thomask77/drquad32/Docs/DrQuad32 Mainboard (Rev B draft) BOM.ods

Layer | Comment | Footprint | Quantity | Designator
Top | 100n | CAPC0402N | 5 | C8, C10, C11, C14, C17
Top | 100R | RESC0402N | 2 | R11, R12
Top | 10k | RESC0402N | 3 | R5, R8, R153
Top | 10uF/25V | CAPC1206N | 12 | C1, C2, C3, C4, C7, C12, C13, C19, C21, C24, C25, C26
Top | 1k | RESC0402N | 5 | R1, R3, R4, R10, R15
Top | 22n | CAPC0603N | 1 | C15
Top | 22u/10V | CAPC1206N | 3 | C5, C6, C23
Top | 2n2/50V | CAPC0402N | 1 | C9
Top | 3k9 | RESC0402N | 1 | R6
Top | 4u7/3A | LDSMSDR0603A | 1 | L1
Top | 820R | RESC0402N | 1 | R7
Top | AT45DB321 | SOIC-8 DATAFLASH | 1 | DF1
Top | BC817-25 | SOT-23A | 5 | Q1, Q2, Q3, Q4, Q5
Top | BMP180 | Bosch BMP180 | 1 | IC2
Top | GREEN | LED0603_GREEN | 1 | LINK
Top | HEADER 1x3 | HEADER 1x3 2.54MM | 2 | PPM, SWD
Top | HEADER 1x4 | HEADER 1x4 2.54MM | 2 | GPS, I2C
Top | HEADER 1x8 | HEADER 1x8 2.54MM | 1 | P2
Top | HEADER 2x8 | HEADER 2x8 2.54MM | 1 | P1
Top | LM1117MP-3.3 | MP04A_N | 1 | U1
Top | MCP16323 | QFN50P300X300X90-16N | 1 | U2
Top | MPU-9150 | Invensense_QFN24 | 1 | IC3
Top | RED | LED0603_RED | 1 | RSSI
Top | USB | USB_MICRO_FCI | 1 | USB
Top | XBee (Pro) | XBeePro_Socket_SMD | 1 | XBee
Bottom | 0R | RESC0402N | 1 | R39
Bottom | 100n | CAPC0402N | 7 | C16, C22, C43, C47, C50, C57, C61
Bottom | 100n | CAPC0603N | 12 | C32, C34, C36, C38, C41, C52, C53, C59, C64, C67, C70, C72
Bottom | 10k | RESC0402N | 12 | R9, R22, R25, R26, R27, R28, R29, R30, R31, R32, R33, R38
Bottom | 10n | CAPC0402N | 12 | C28, C29, C30, C39, C42, C51, C55, C56, C62, C68, C71, C74
Bottom | 16MHz | XO2.5x2.0 | 1 | X1
Bottom | 1k | RESC0402N | 15 | R17, R19, R21, R23, R34, R35, R37, R41, R42, R45, R46, R48, R51, R53, R55
Bottom | 1uF/25V | CAPC0603N | 12 | C31, C33, C35, C37, C40, C49, C54, C58, C65, C66, C69, C73
Bottom | 22p | CAPC0402N | 2 | C45, C46
Bottom | 2u2 | CAPC0402N | 3 | C18, C20, C60
Bottom | 330uF/25V | CAPE_RM5_D10_H12 | 4 | C27, C48, C63, C75
Bottom | 5k6 | RESC0402N | 13 | R16, R18, R20, R24, R36, R40, R43, R44, R47, R49, R50, R52, R54
Bottom | 600R/100MHz | RESC0402N | 1 | LF1
Bottom | 74HC1G14 | SOT65P210X100-5N | 1 | IC1
Bottom | MBR120 | D_SM_SOD123_H135A | 1 | D1
Bottom | SiC780 | DRMOS40 | 12 | DR1, DR2, DR3, DR4, DR5, DR6, DR7, DR8, DR9, DR10, DR11, DR12
Bottom | STM32F4 | TSQFP50P1600X1600X160-100N | 1 | IC4
