thomask77/drquad32/Docs/TODO.TXT

* memmang 4
* ccm-ram direkt eintragen (NOLOAD)
