thomask77/drquad32/Docs/DrQuad32 Mainboard (Rev B draft).pdf

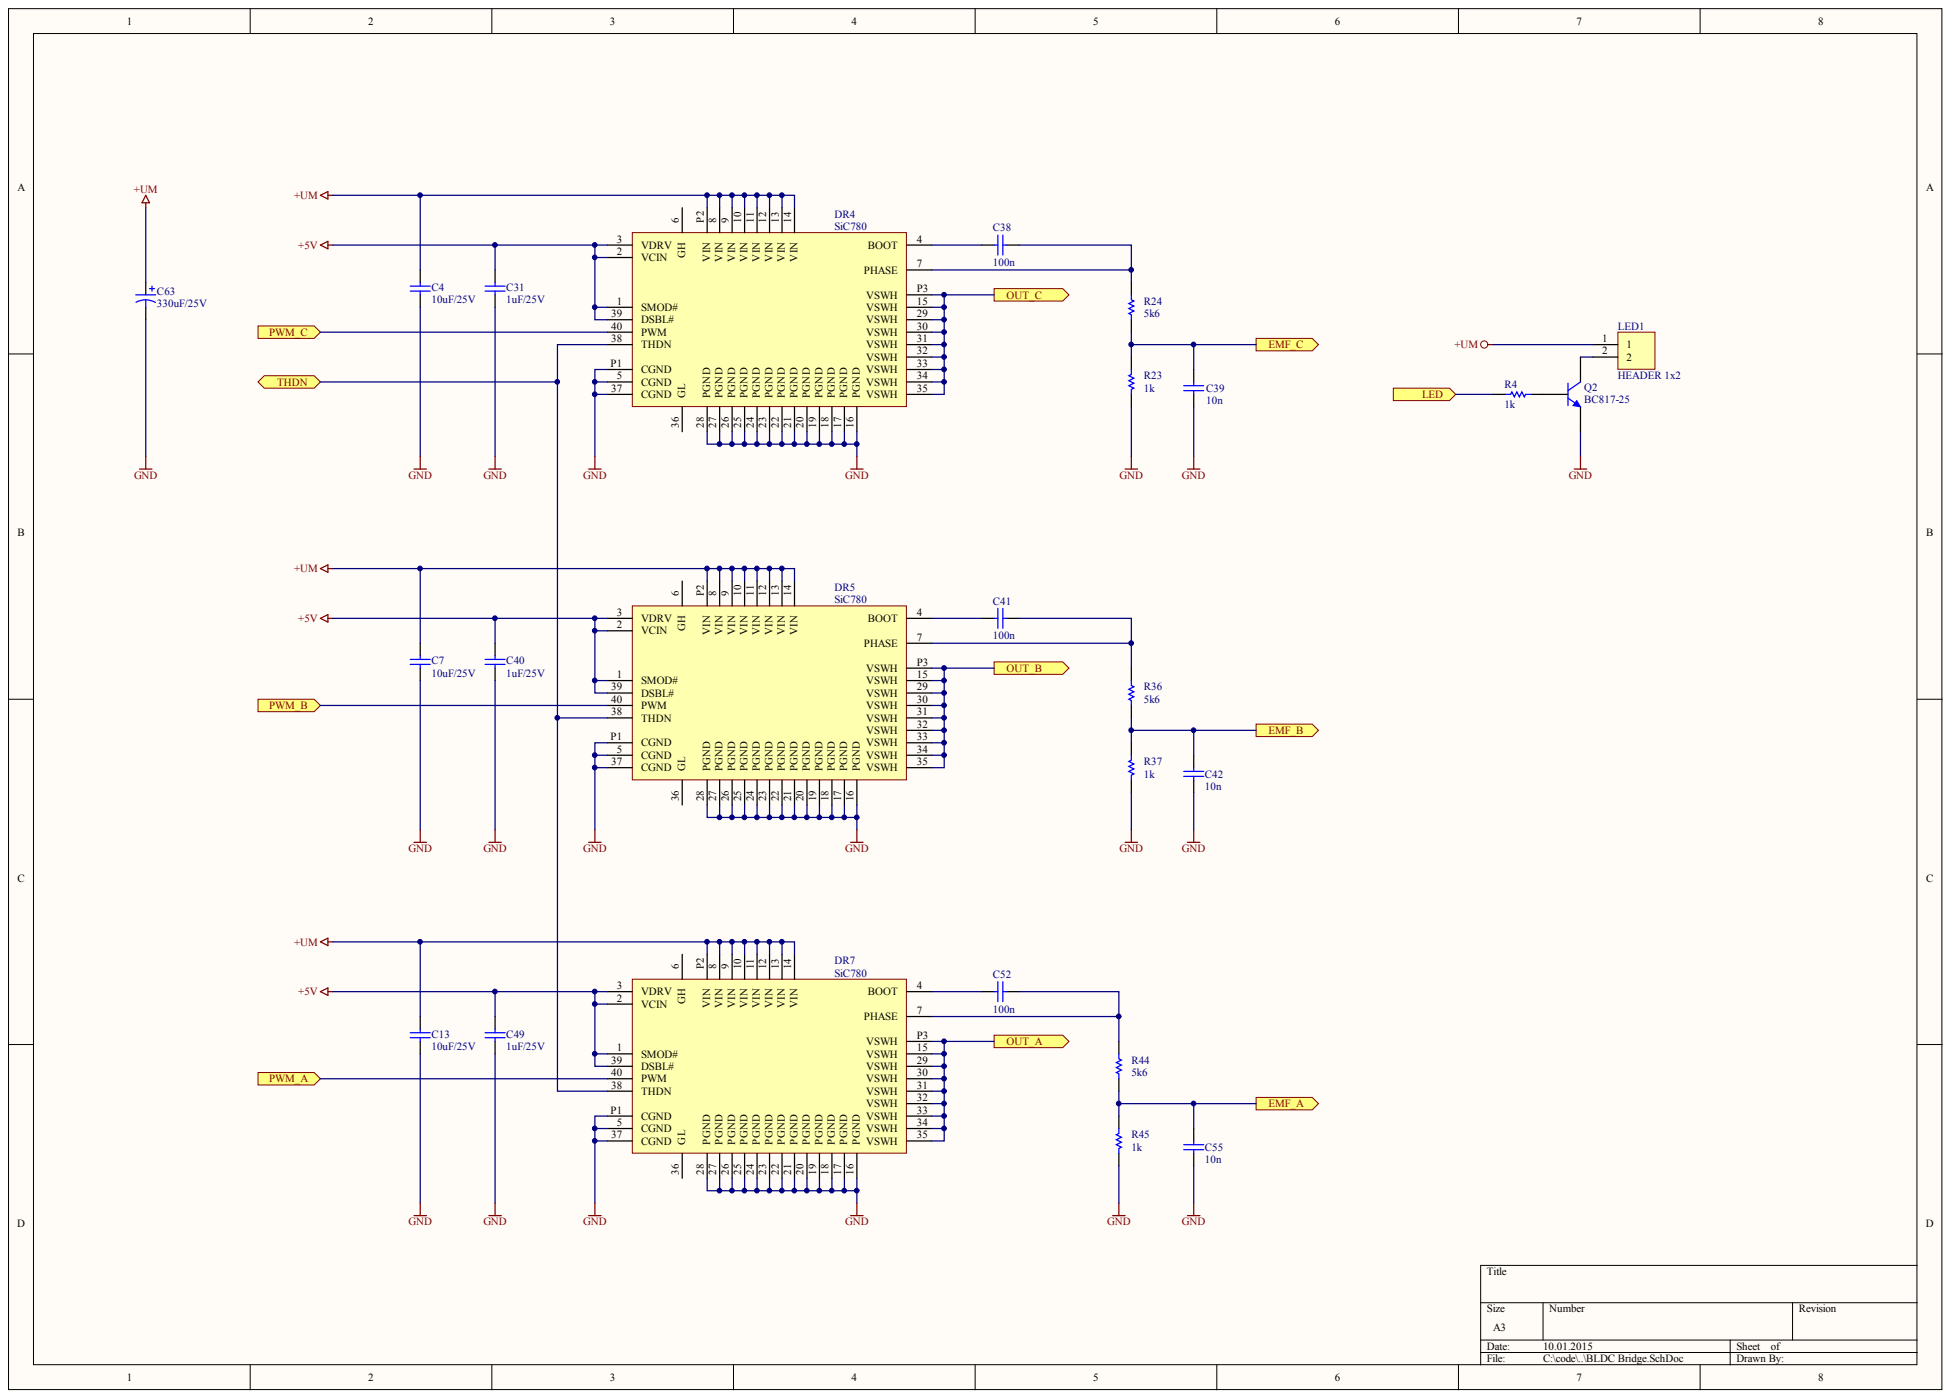
[picture p1: page 1]

PGND 17 PGND 18 PGND 19 PGND 20 PGND 21 PGND 22 PGND 23 PGND 24 PGND 25 PGND 26 PGND 27 PGND 28

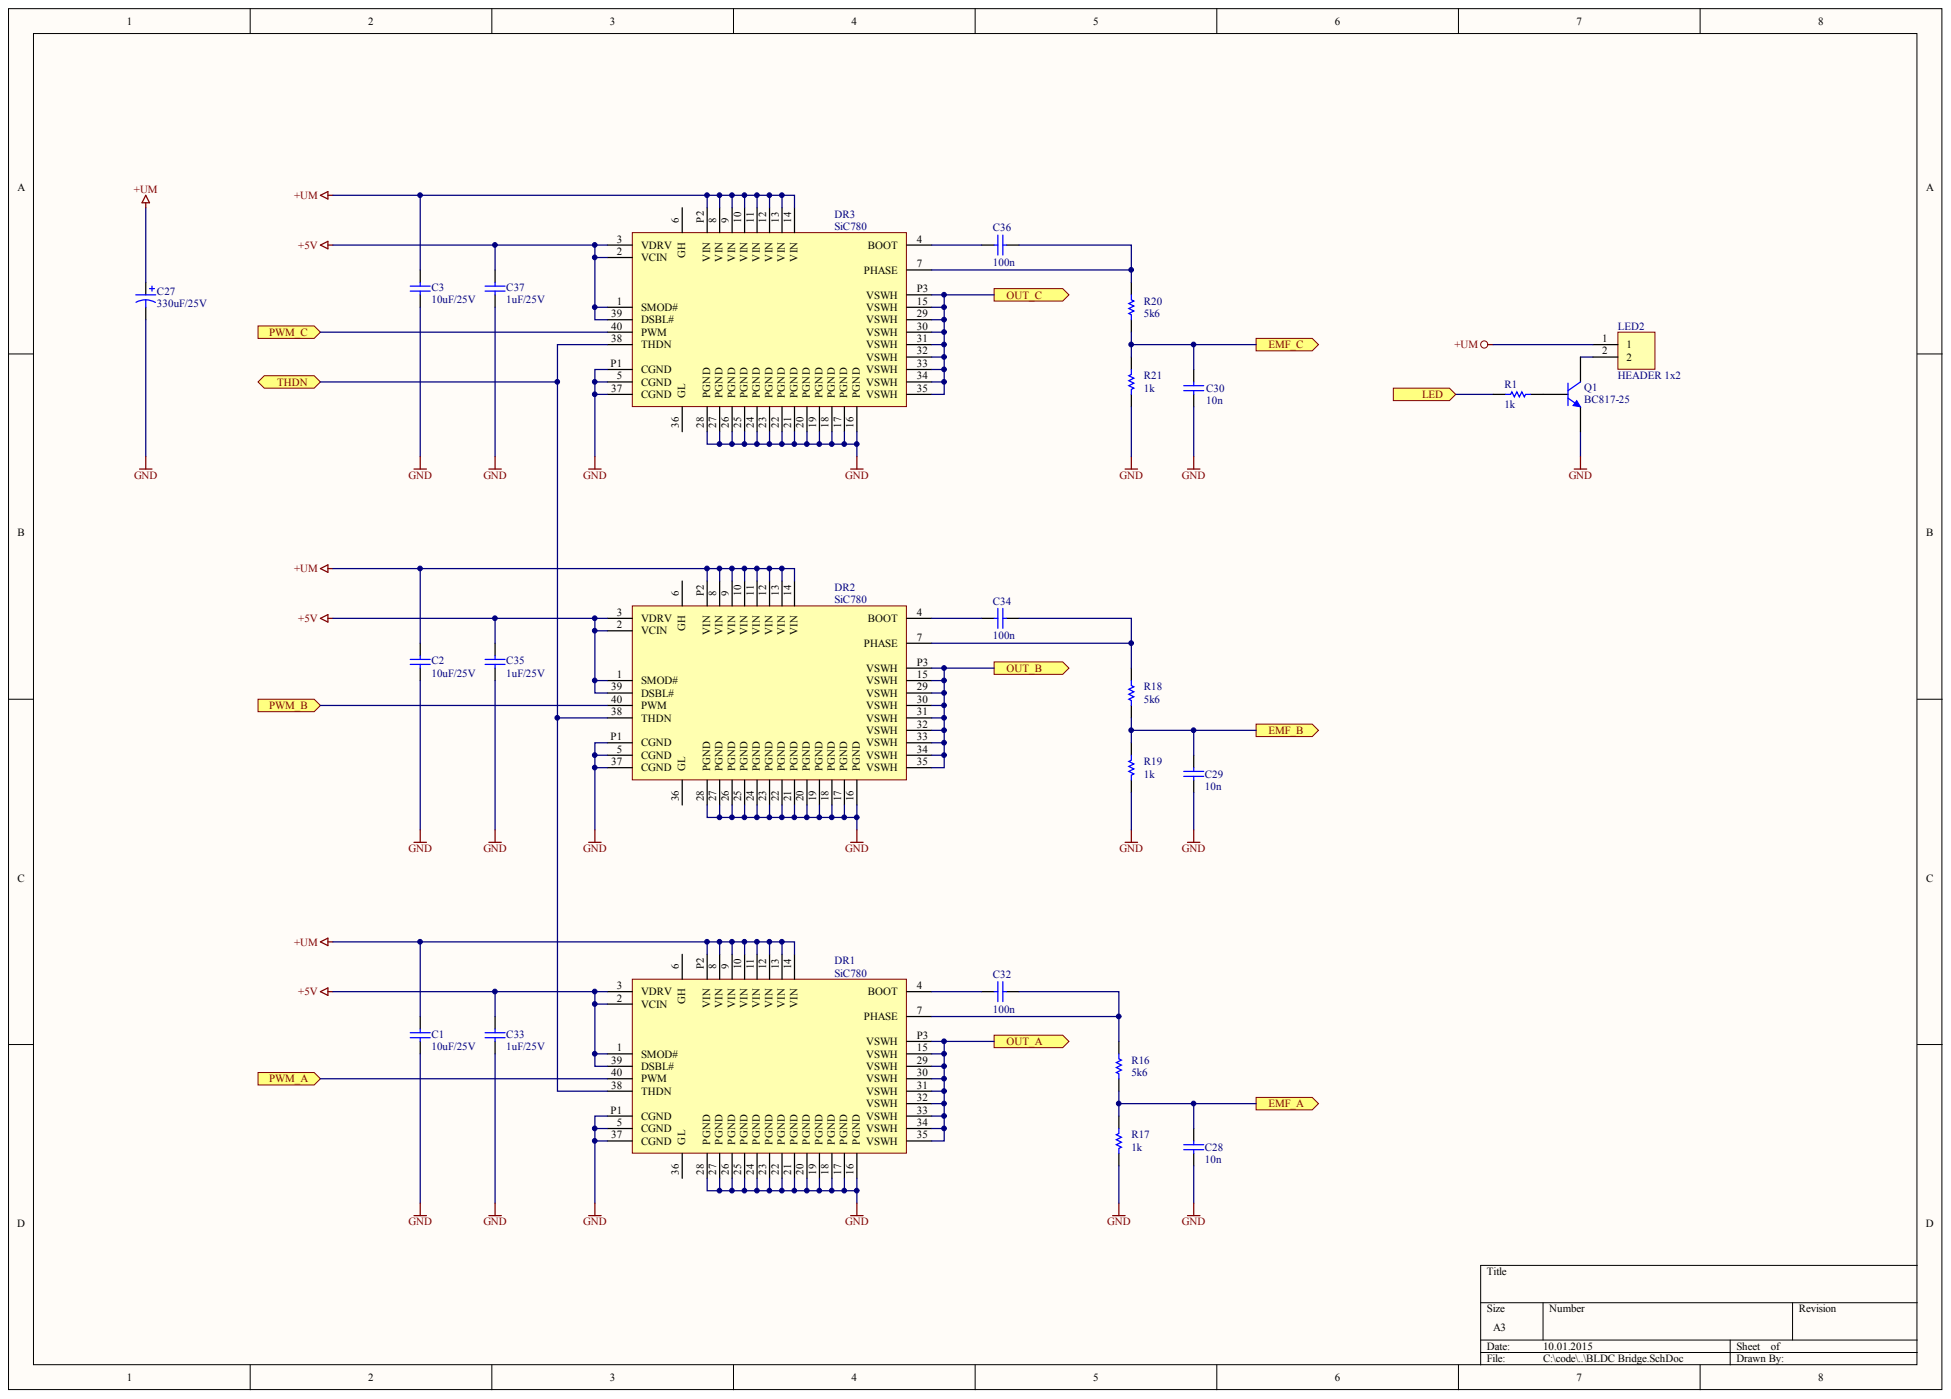
[picture p2: page 2]
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

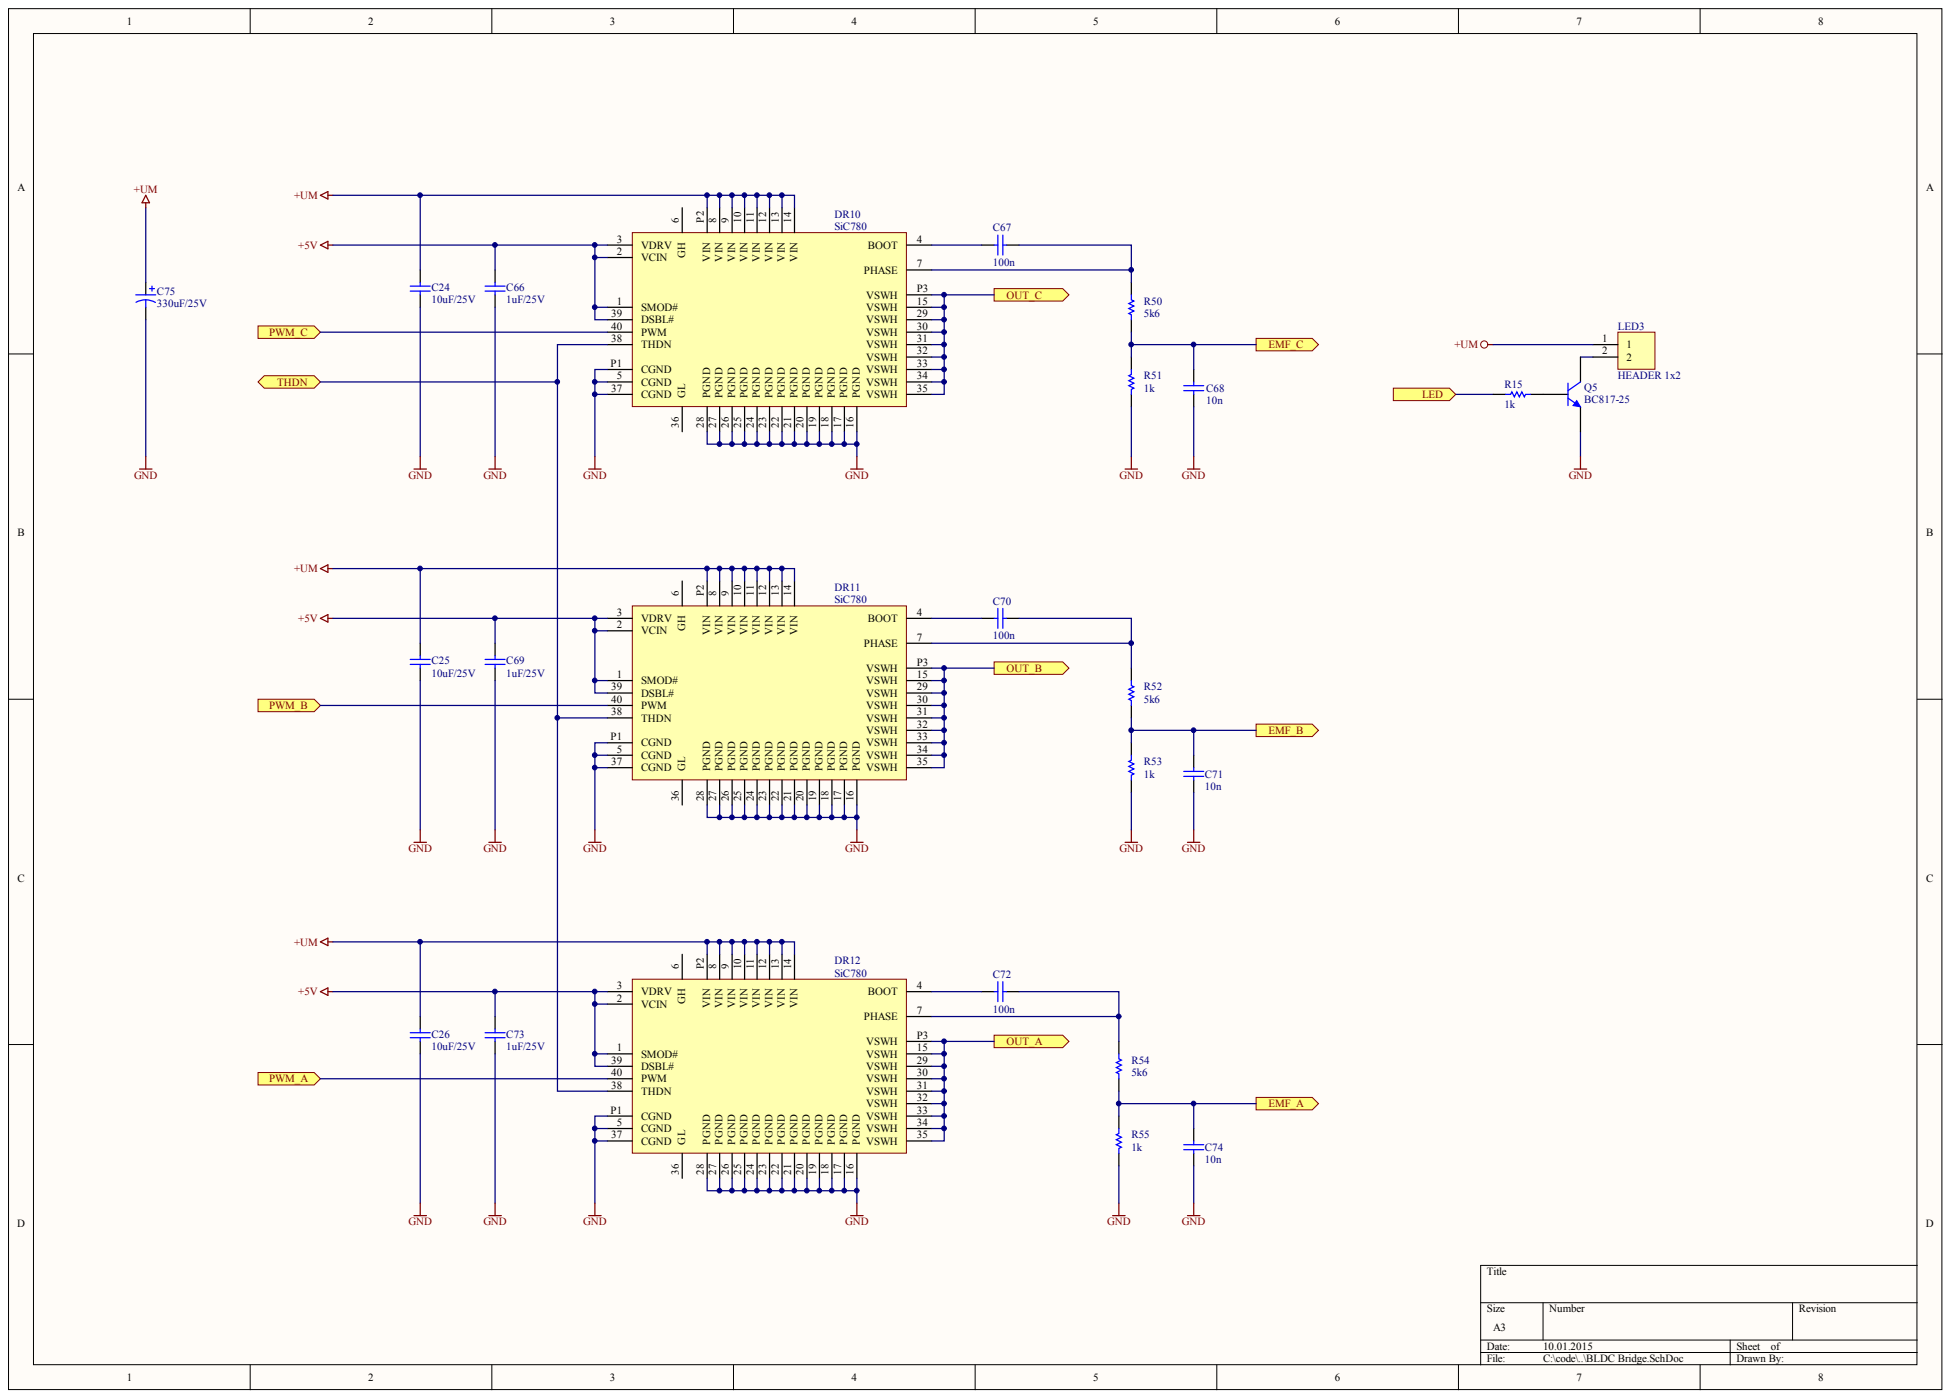
[picture p3: page 3]
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

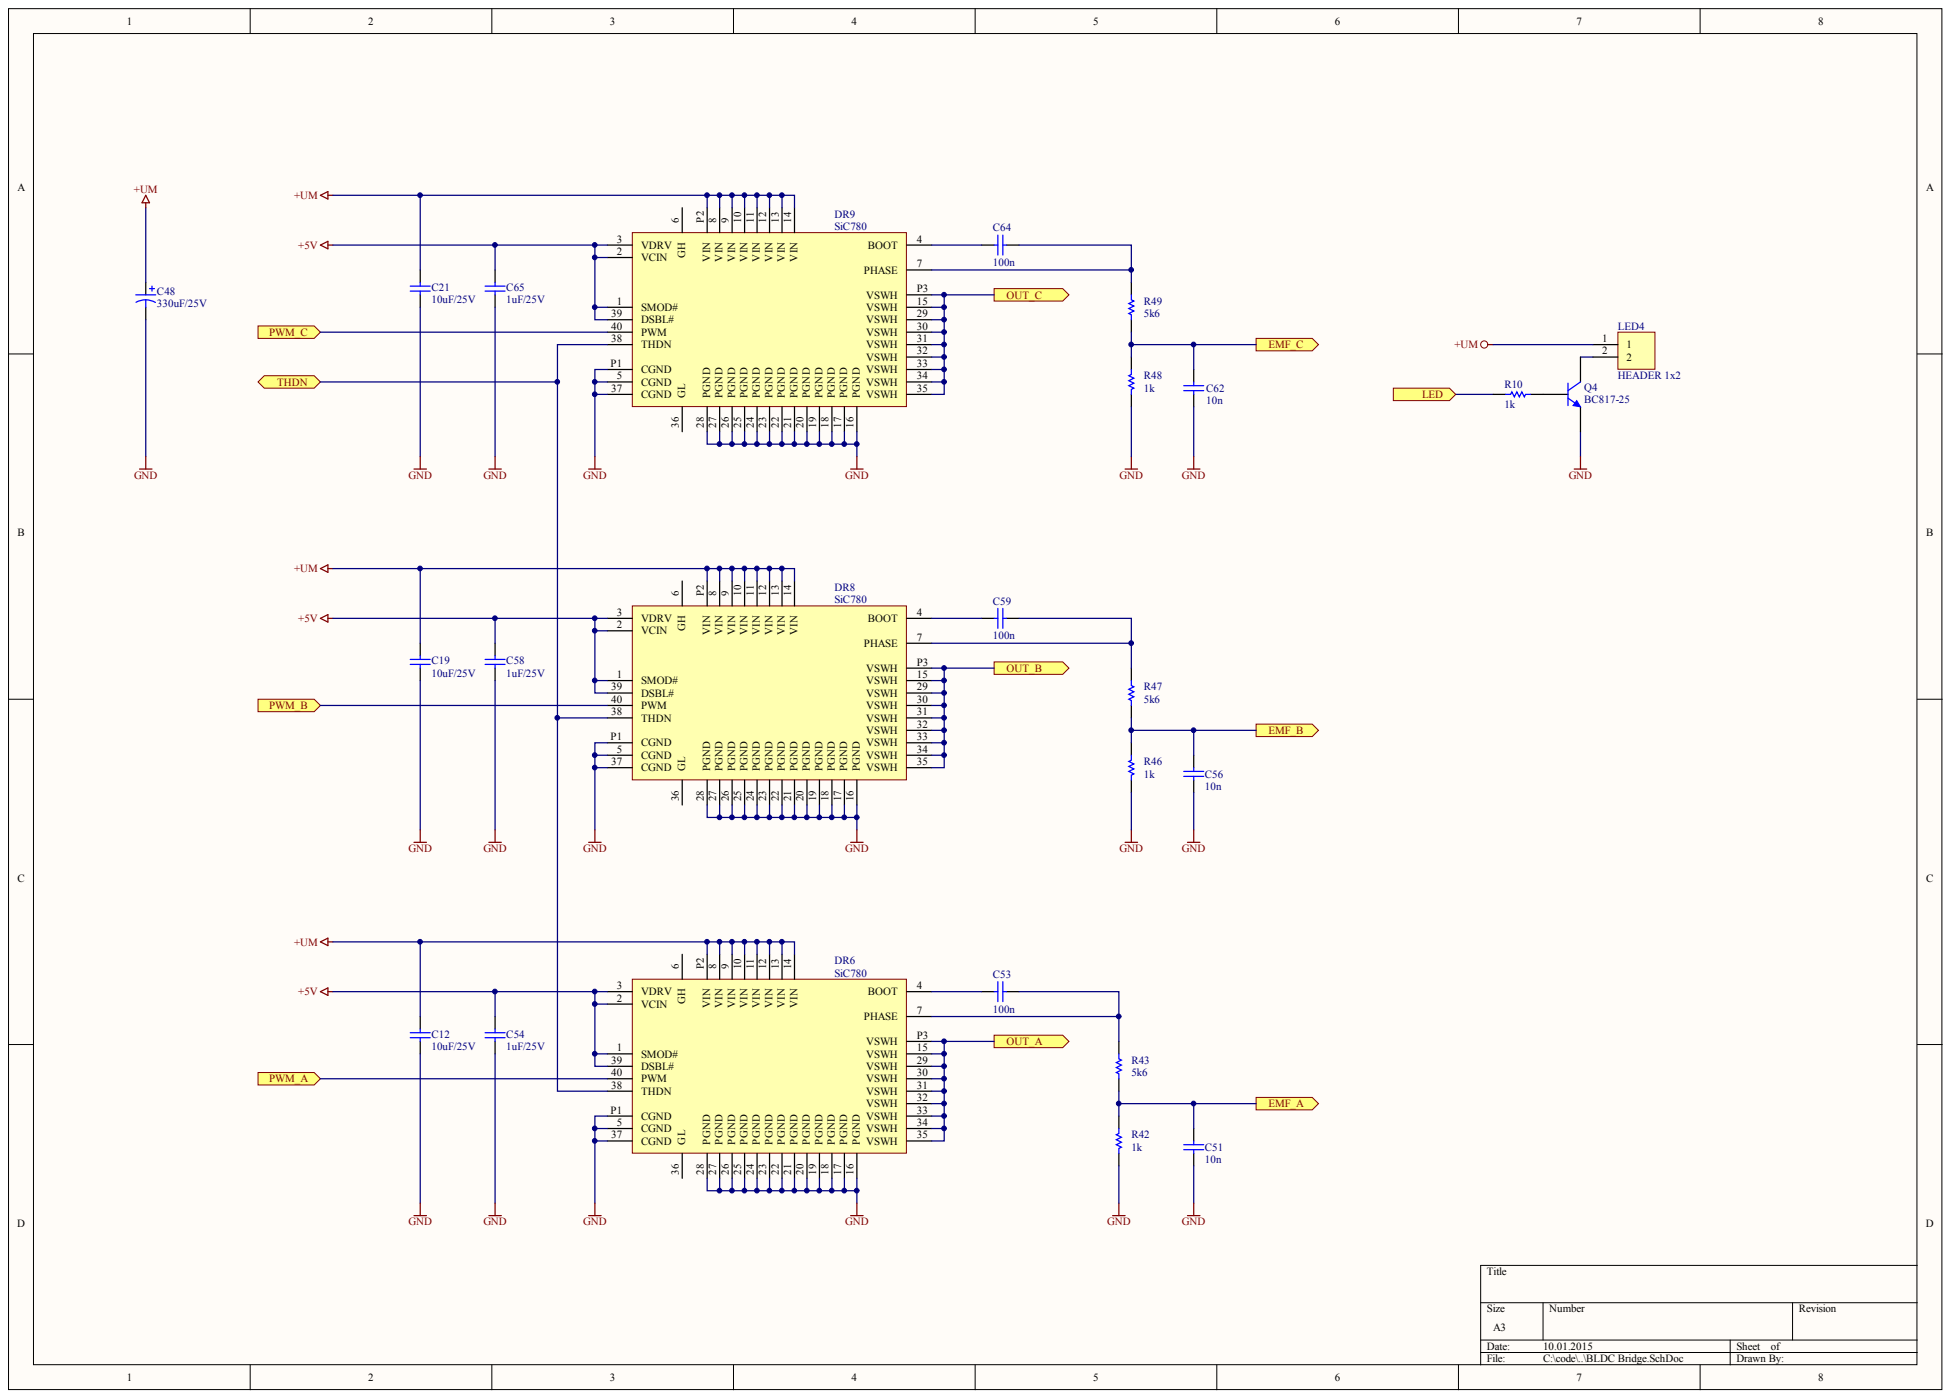
[picture p4: page 4]
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

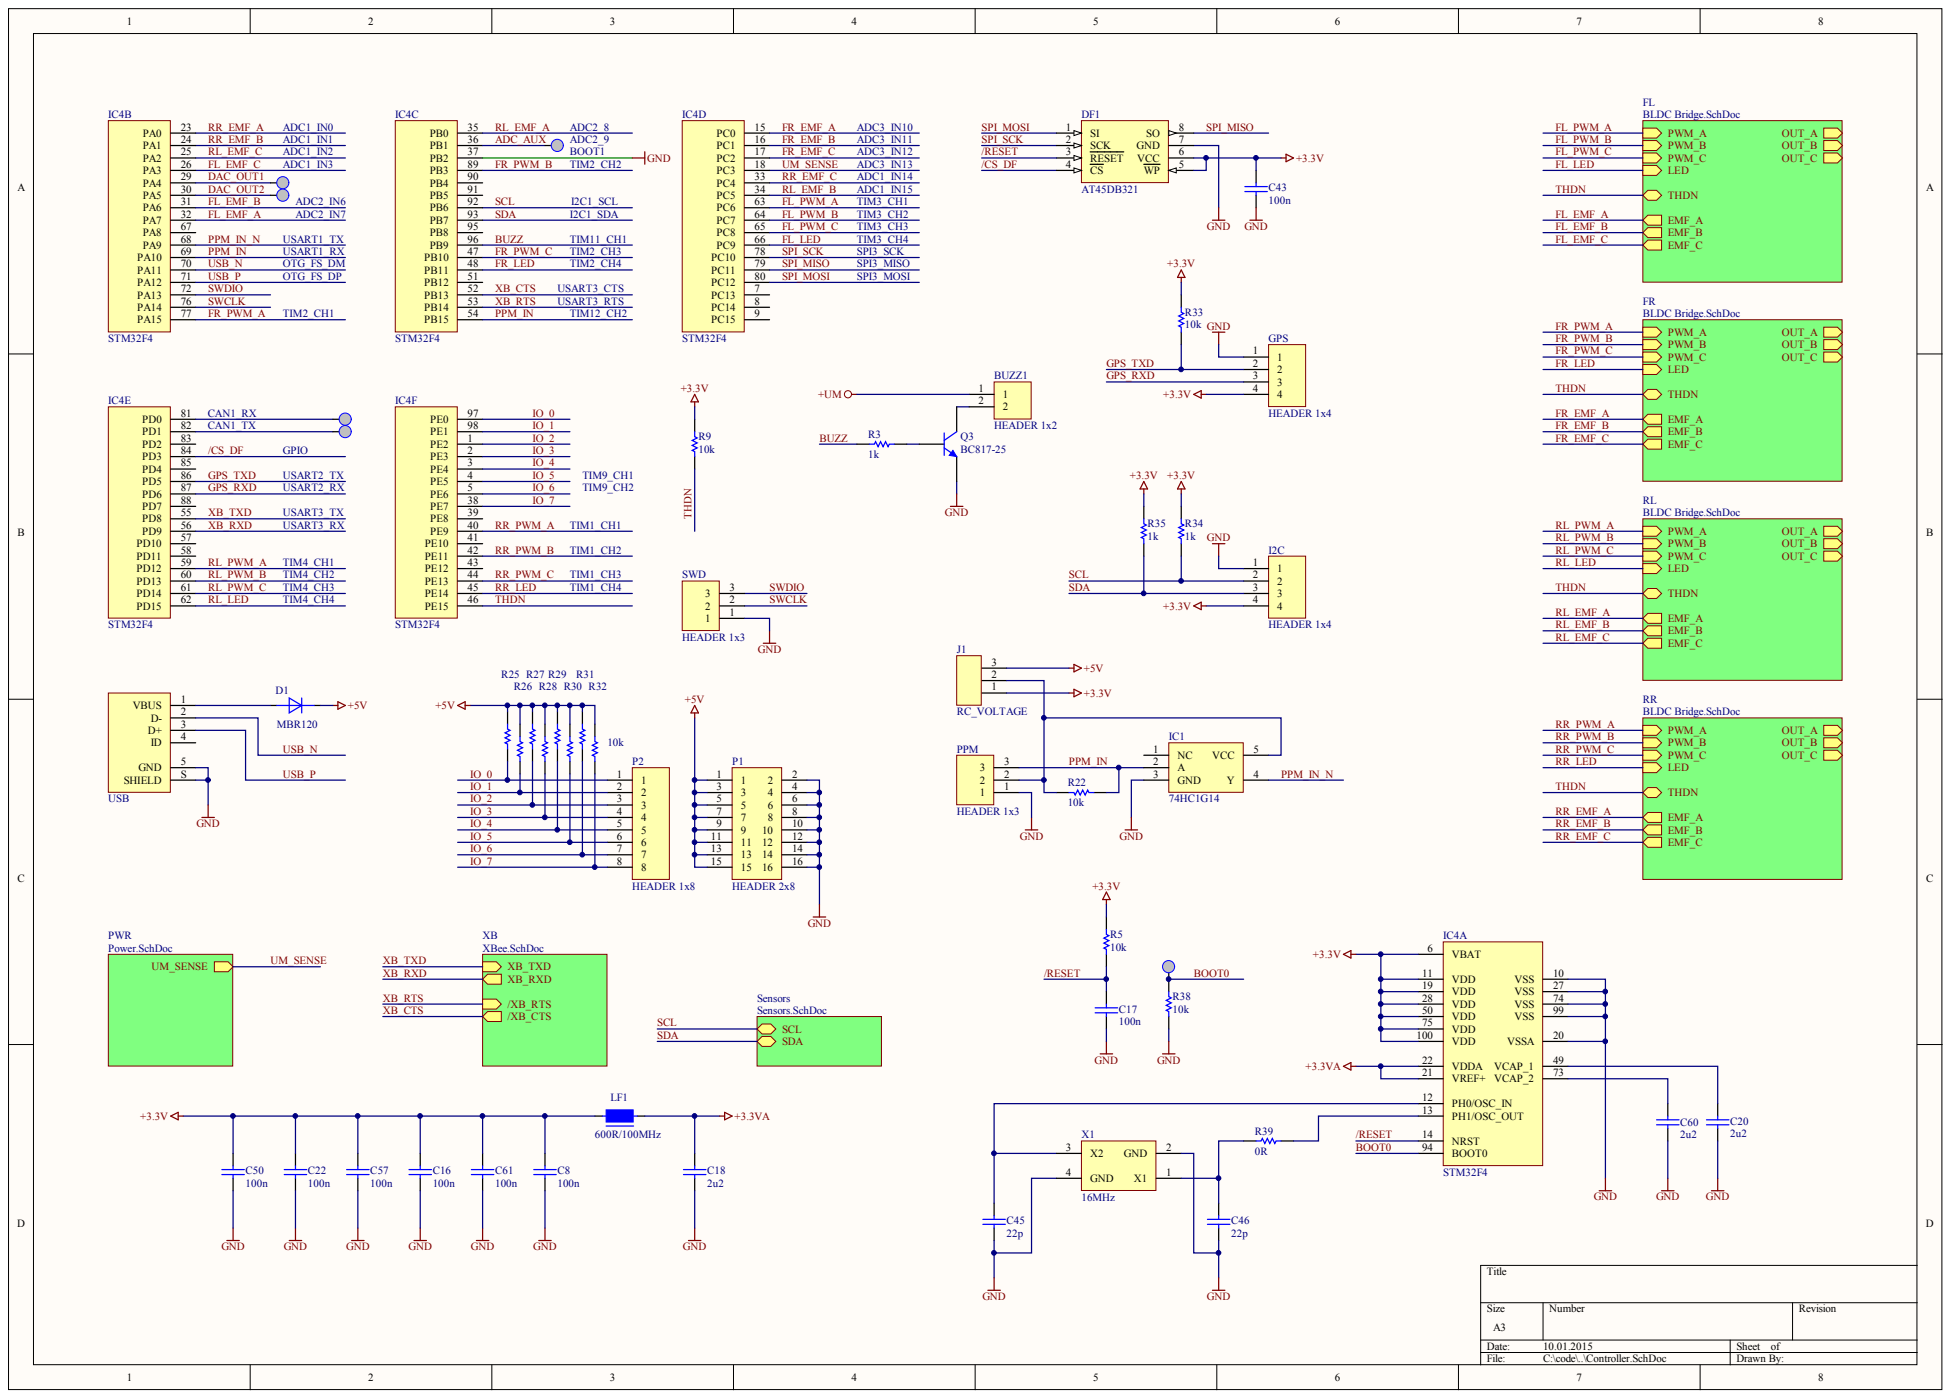
[picture p5: page 5]

PH1/OSC_OUT 13

/RESET | NRST 14

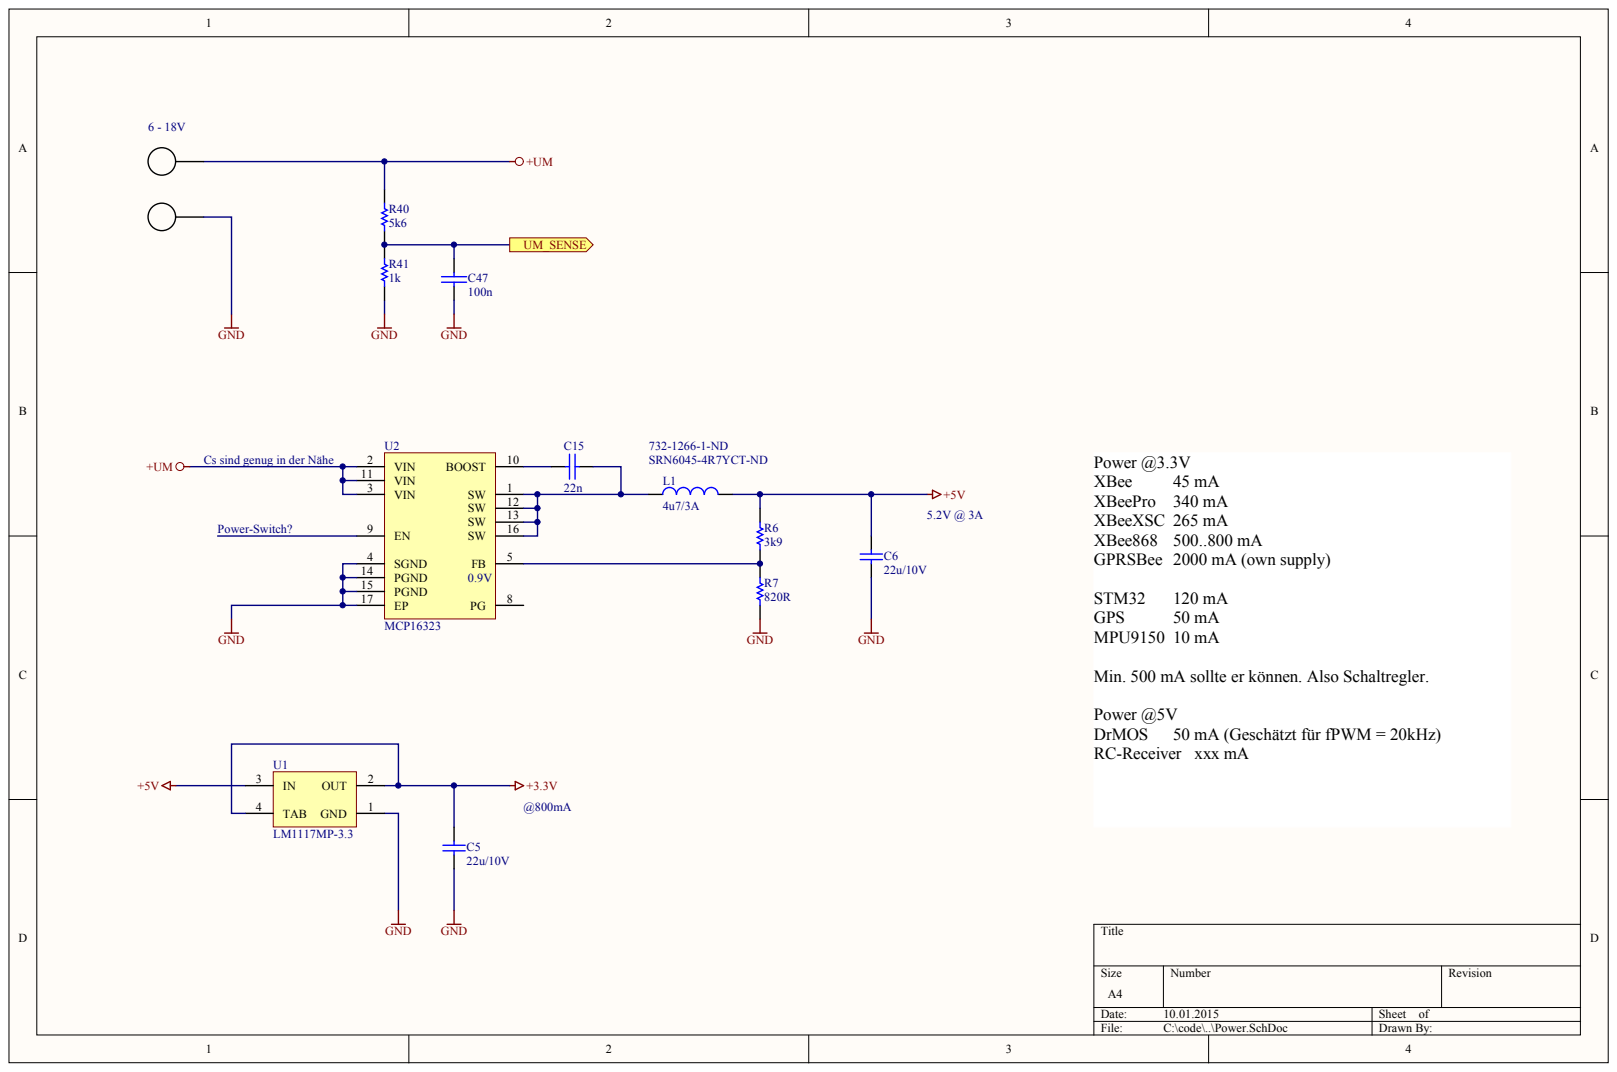
[picture p6: page 6]

Cs sind genug in der Nähe

Power @3.3V
XBeePro 340 mA
XBeeXSC 265 mA
XBee868 500..800 mA
GPRSBee 2000 mA (own supply)

PGND 14

Min. 500 mA sollte er können. Also Schaltregler.

Power @5V
RC-Receiver xxx mA

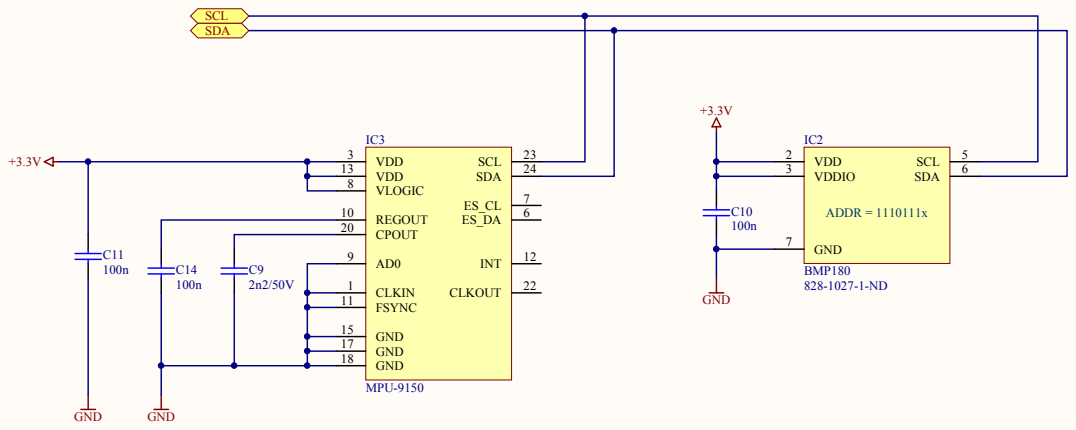
[picture p7: page 7]

1 | 2 2
1 1

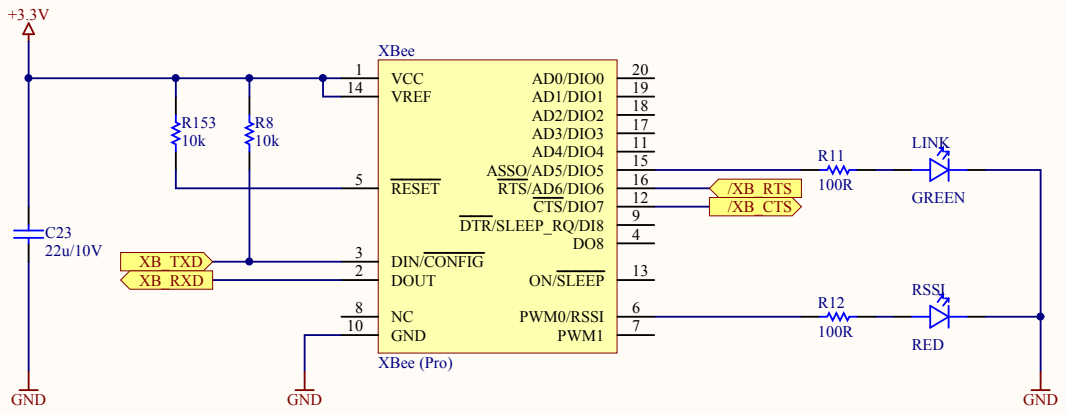
[picture p8: page 8]

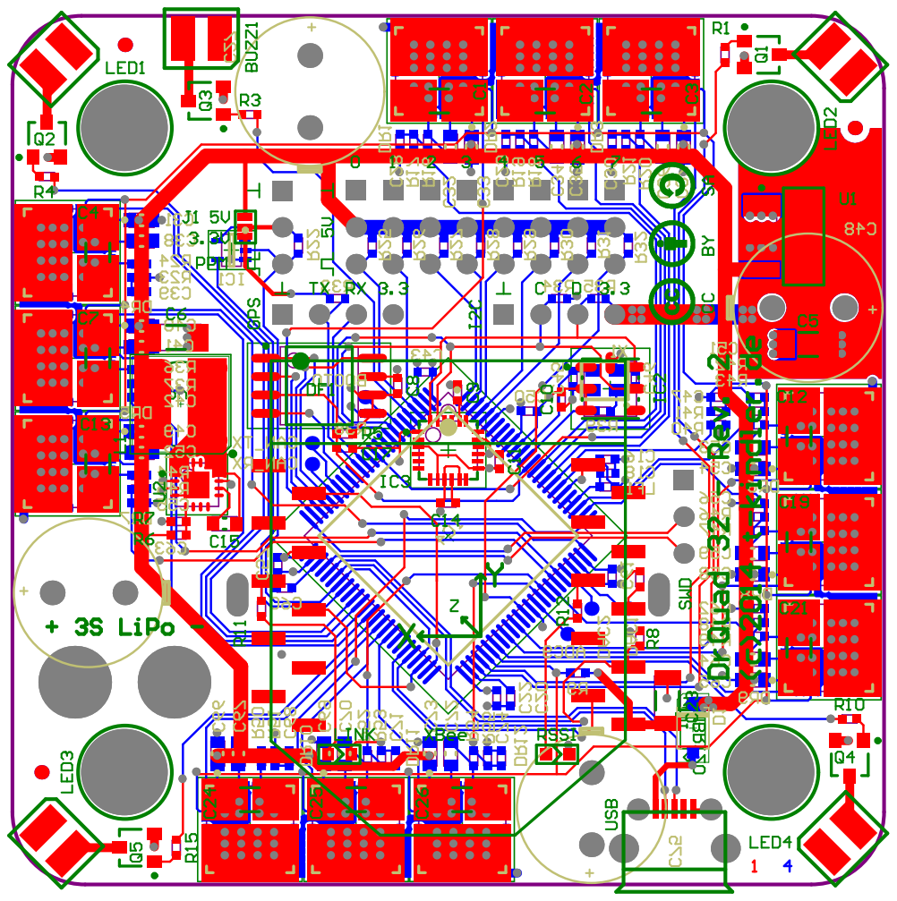
[picture p9: page 9]

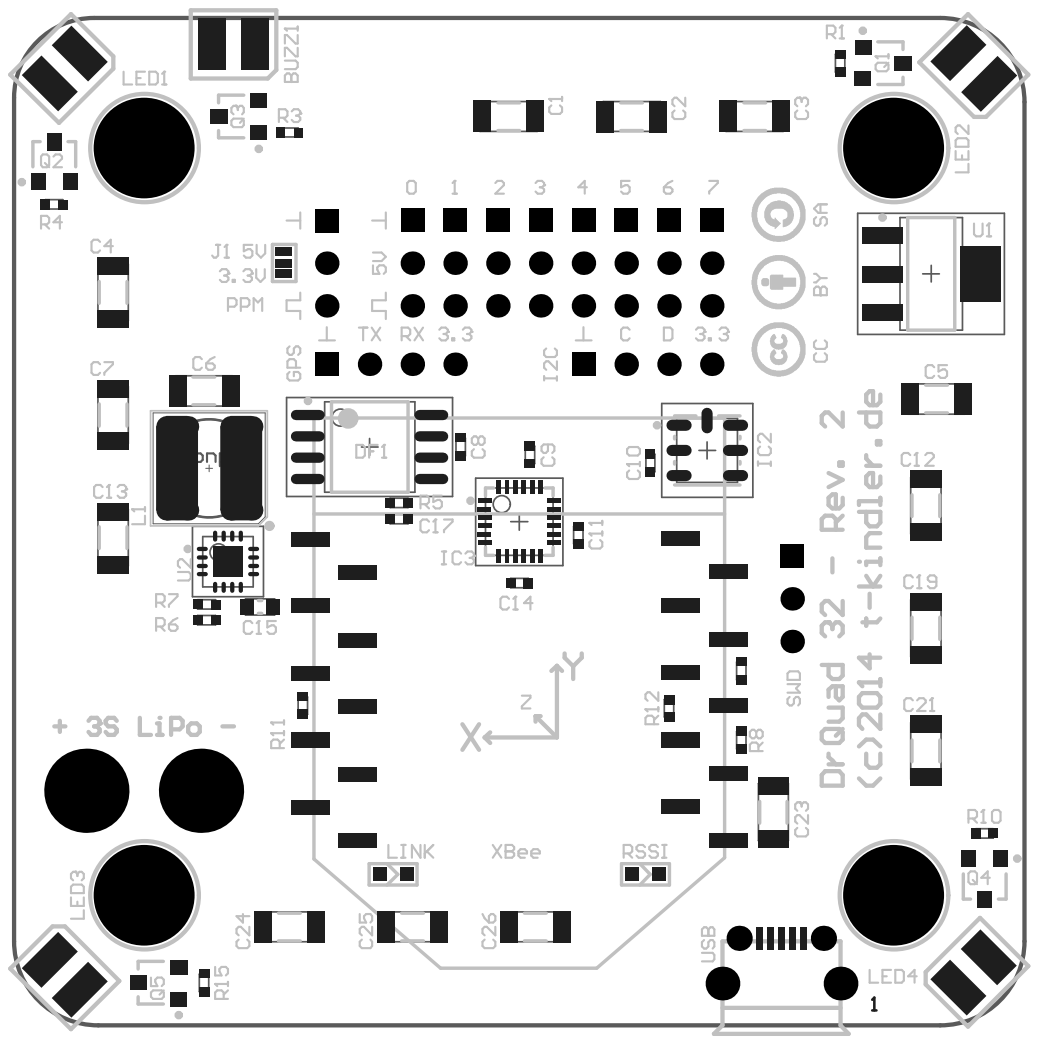
[picture p10: page 10]

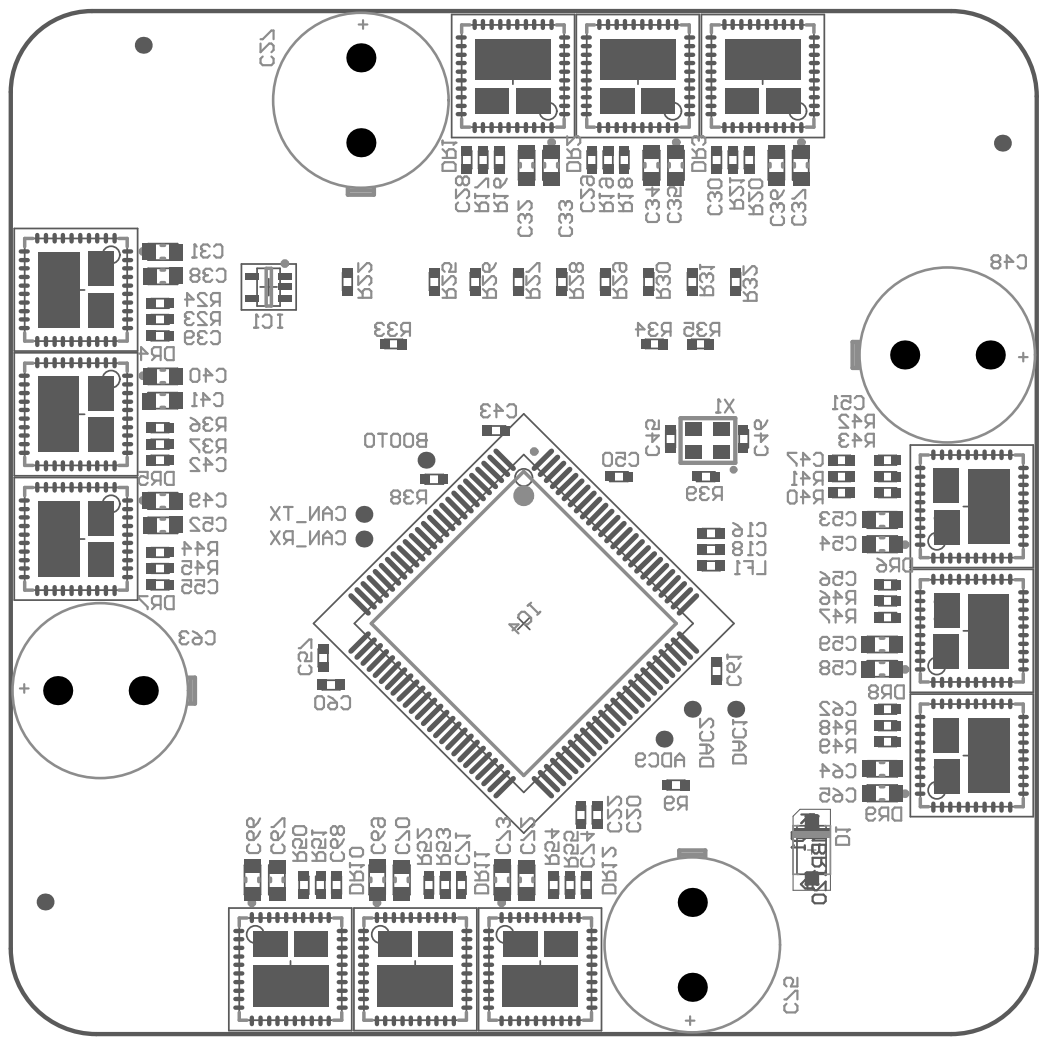
[picture p11: page 11]
