thomask77/drquad32/QuadControl/main.cpp

/**
 * Copyright (C)2015 Thomas Kindler <mail_drquad@t-kindler.de>
 *
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
 * You should have received a copy of the GNU General Public License
 * along with this program.  If not, see <http://www.gnu.org/licenses/>.
 */

#include <QApplication>
#include "MainWindow.h"
#include "VersionInfo.h"

int main(int argc, char *argv[])
{
    QApplication a(argc, argv);

    a.setApplicationName((char*)versionInfo.product_name);
    a.setApplicationVersion(
        QString("%1.%2.%3 %4")
            .arg(versionInfo.major)
            .arg(versionInfo.minor)
            .arg(versionInfo.patch)
            .arg((char*)versionInfo.vcs_id)
    );
    a.setOrganizationDomain("t-kindler.de");

    mainWindow = new MainWindow();
    mainWindow->show();

    auto res = a.exec();

    delete mainWindow;
    return res;
}
