thomask77/drquad32/QuadControl/PuTTYLauncher.cpp

/**
 * Launch PuTTY on Windows and Linux with a customizable configuration
 *
 * Copyright (C)2015 Thomas Kindler <mail_drquad@t-kindler.de>
 *
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
 * You should have received a copy of the GNU General Public License
 * along with this program.  If not, see <http://www.gnu.org/licenses/>.
 */

#include "PuTTYLauncher.h"

#include <QDebug>
#include <QSettings>
#include <QSerialPortInfo>
#include <QUuid>
#include <QFile>
#include <QDir>
#include <QUrl>

PuTTYLauncher::PuTTYLauncher(QWidget *parent)
    : QWidget(parent)
{
#ifdef Q_OS_WIN
    QString programFilesPath(qgetenv("PROGRAMFILES"));
    puttyFilename = programFilesPath + "\\PuTTY\\putty.exe";
#else
    puttyFilename = "/usr/bin/putty";
#endif

    connect(&process, &QProcess::started, this, &PuTTYLauncher::started);
    connect(&process, (void (QProcess::*)(int))&QProcess::finished, this, &PuTTYLauncher::finished);
}


PuTTYLauncher::~PuTTYLauncher()
{
    if (process.state() == QProcess::Running)
        process.terminate();
}


QString PuTTYLauncher::errorString()
{
    return m_errorString;
}


bool PuTTYLauncher::openUrl(const QUrl &url)
{
    settings["ScrollbackLines"] = 10000;
    settings["WarnOnClose"] = 0;
    settings["TermWidth"] = 80;     // EGA style :)
    settings["TermHeight"] = 43;

    settings["WinTitle"] = "PuTTY - " + url.toString();

    if (url.scheme() == "serial") {
        settings["Protocol"] = "serial";
        settings["SerialLine"] = QSerialPortInfo(url.path()).systemLocation();
        settings["SerialSpeed"] = url.query().toInt();
        settings["SerialFlowControl"] = 2;  // 2 = RTS/CTS
    }
    else if (url.scheme() == "wifly") {
        settings["Protocol"] = "raw";
        settings["HostName"] = url.host();
        settings["PortNumber"] = url.port();
        settings["LocalEcho"] = 1;  // 0 = On, 1 = Off, 2 = Auto
        settings["LocalEdit"] = 1;  // 0 = On, 1 = Off, 2 = Auto
    }
    else {
        m_errorString = "Unknown URL scheme";
        return false;
    }

    return openSession();
}


bool PuTTYLauncher::openSession()
{
#ifdef Q_OS_WIN
    QSettings registry(
        "HKEY_CURRENT_USER\\Software\\SimonTatham\\PuTTY\\Sessions",
        QSettings::NativeFormat
    );

    registry.beginGroup(sessionName);

    for (auto k: settings.keys())
        registry.setValue(k, settings[k]);

    registry.endGroup();
    registry.sync();

#else
    auto sessionPath = QDir::homePath() + "/.putty/sessions/";
    QDir().mkpath(sessionPath);

    QFile file(sessionPath + sessionName);

    if (!file.open(QIODevice::WriteOnly)) {
        m_errorString = file.errorString();
        return false;
    }

    QTextStream out(&file);
    for (auto k: settings.keys())
        out << k << "=" << settings[k].toString() << "\n";

    file.close();
#endif

    process.start(puttyFilename, QStringList({ "-load", sessionName }));

    if (!process.waitForStarted()) {
        m_errorString = process.errorString();
        return false;
    }

    return true;
}
