thomask77/drquad32/QuadControl/TangoColors.cpp

#include "TangoColors.h"

const QColor TangoColors::Butter1     = QColor( 252, 233,  79 );
const QColor TangoColors::Butter2     = QColor( 237, 212,   0 );
const QColor TangoColors::Butter3     = QColor( 196, 160,   0 );
const QColor TangoColors::Chameleon1  = QColor( 138, 226,  52 );
const QColor TangoColors::Chameleon2  = QColor( 115, 210,  22 );
const QColor TangoColors::Chameleon3  = QColor(  78, 154,   6 );
const QColor TangoColors::Orange1     = QColor( 252, 175,  62 );
const QColor TangoColors::Orange2     = QColor( 245, 121,   0 );
const QColor TangoColors::Orange3     = QColor( 206,  92,   0 );
const QColor TangoColors::SkyBlue1    = QColor( 114, 159, 207 );
const QColor TangoColors::SkyBlue2    = QColor(  52, 101, 164 );
const QColor TangoColors::SkyBlue3    = QColor(  32,  74, 135 );
const QColor TangoColors::Plum1       = QColor( 173, 127, 168 );
const QColor TangoColors::Plum2       = QColor( 117,  80, 123 );
const QColor TangoColors::Plum3       = QColor(  92,  53, 102 );
const QColor TangoColors::Chocolate1  = QColor( 233, 185, 110 );
const QColor TangoColors::Chocolate2  = QColor( 193, 125,  17 );
const QColor TangoColors::Chocolate3  = QColor( 143,  89,   2 );
const QColor TangoColors::ScarletRed1 = QColor( 239,  41,  41 );
const QColor TangoColors::ScarletRed2 = QColor( 204,   0,   0 );
const QColor TangoColors::ScarletRed3 = QColor( 164,   0,   0 );
const QColor TangoColors::Aluminium1  = QColor( 238, 238, 236 );
const QColor TangoColors::Aluminium2  = QColor( 211, 215, 207 );
const QColor TangoColors::Aluminium3  = QColor( 186, 189, 182 );
const QColor TangoColors::Aluminium4  = QColor( 136, 138, 133 );
const QColor TangoColors::Aluminium5  = QColor(  85,  87,  83 );
const QColor TangoColors::Aluminium6  = QColor(  46,  52,  54 );

const QColor GnomeColors::Basic3DHilight  = QColor( 234, 232, 227 );
const QColor GnomeColors::Basic3DMedium   = QColor( 186, 181, 171 );
const QColor GnomeColors::Basic3DDark     = QColor( 128, 125, 116 );
const QColor GnomeColors::_3DShadow       = QColor(  86,  82,  72 );
const QColor GnomeColors::GreenHilight    = QColor( 197, 210, 200 );
const QColor GnomeColors::GreenMedium     = QColor( 131, 166, 127 );
const QColor GnomeColors::GreenDark       = QColor(  93, 117,  85 );
const QColor GnomeColors::GreenShadow     = QColor(  68,  86,  50 );
const QColor GnomeColors::RedHilight      = QColor( 224, 182, 175 );
const QColor GnomeColors::RedMedium       = QColor( 193, 102,  90 );
const QColor GnomeColors::RedDark         = QColor( 136,  70,  49 );
const QColor GnomeColors::RedShadow       = QColor( 102,  56,  34 );
const QColor GnomeColors::PurpleHilight   = QColor( 173, 167, 200 );
const QColor GnomeColors::PuprpleMedium   = QColor( 136, 127, 163 );
const QColor GnomeColors::PurpleDark      = QColor(  98,  91, 129 );
const QColor GnomeColors::PurpleShadow    = QColor(  73,  64, 102 );
const QColor GnomeColors::BlueHilight     = QColor( 157, 184, 210 );
const QColor GnomeColors::BlueMedium      = QColor( 117, 144, 174 );
const QColor GnomeColors::BlueDark        = QColor(  75, 105, 131 );
const QColor GnomeColors::BlueShadow      = QColor(  49,  78, 108 );
const QColor GnomeColors::FaceSkinHilight = QColor( 239, 224, 205 );
const QColor GnomeColors::FaceSkinMedium  = QColor( 224, 195, 158 );
const QColor GnomeColors::FaceSkinDark    = QColor( 179, 145, 105 );
const QColor GnomeColors::FaceSkinShadow  = QColor( 130, 102,  71 );
const QColor GnomeColors::AccentRed       = QColor( 223,  66,  30 );
const QColor GnomeColors::AccentRedDark   = QColor( 153,   0,   0 );
const QColor GnomeColors::AccentYellow    = QColor( 238, 214, 128 );
const QColor GnomeColors::AccentYellowDark= QColor( 209, 148,  12 );
const QColor GnomeColors::AccentGreen     = QColor(  70, 160,  70 );
const QColor GnomeColors::AccentGreenDark = QColor(  38, 199,  38 );
const QColor GnomeColors::White           = QColor( 255, 255, 255 );
const QColor GnomeColors::Black           = QColor(   0,   0,   0 );
