thomask77/drquad32/QuadControl/WiFlyListener.cpp

/**
 * UDP broadcast receiver for Roving Networks/Microchip WiFly Modules
 *
 * Copyright (C)2015 Thomas Kindler <mail_drquad@t-kindler.de>
 *
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
 * You should have received a copy of the GNU General Public License
 * along with this program.  If not, see <http://www.gnu.org/licenses/>.
 */

#include "WiFlyListener.h"

#include <QtEndian>


#pragma pack(push, 1)
struct BroadcastPacket {
    uint8_t     apMacAddress[6];    // 0-5
    uint8_t     channel;            // 6
    uint8_t     rssi;               // 7
    uint16_t    be_localPort;       // 8
    uint32_t    be_rtcValue;        // 10
    uint16_t    be_uBat;            // 14
    uint16_t    be_gpioPins;        // 16
    char        asciiTime[13+1];    // 18
    char        version[26+2];      // 32
    char        deviceId[32];       // 60
    uint16_t    be_bootTime;        // 92
    uint16_t    be_sensors[8];      // 94
};
#pragma pack(pop)


bool WiFlyClientInfo::fromPacket(const QByteArray &packet, const QHostAddress &addr)
{
    if (packet.size() != sizeof(BroadcastPacket))
        return false;

    auto &p = *(const BroadcastPacket *)packet.constData();

    address = addr;
    lastSeen = QDateTime::currentDateTime();

    apMacAddress.sprintf(
        "%02x:%02x:%02x:%02x:%02x:%02x",
        p.apMacAddress[0], p.apMacAddress[1],
        p.apMacAddress[2], p.apMacAddress[3],
        p.apMacAddress[4], p.apMacAddress[5]
    );

    channel    = p.channel;
    rssi       = p.rssi;
    localPort  = qFromBigEndian(p.be_localPort);
    rtcValue   = qFromBigEndian(p.be_rtcValue);
    uBat       = qFromBigEndian(p.be_uBat);
    gpioPins   = qFromBigEndian(p.be_gpioPins);

    asciiTime.sprintf("%.*s", (int)sizeof(p.asciiTime), p.asciiTime);
    version.sprintf("%.*s", (int)sizeof(p.version), p.version);
    deviceId.sprintf("%.*s", (int)sizeof(p.deviceId), p.deviceId);
    bootTime_ms = qFromBigEndian(p.be_bootTime);

    for (int i=0; i<8; i++)
        sensors[i] = qFromBigEndian(p.be_sensors[i]);

    return true;
}


WiFlyListener::WiFlyListener(QObject *parent)
    : QObject(parent)
{
    socket.bind(BROADCAST_PORT, QUdpSocket::ShareAddress);
    connect(&socket, &QUdpSocket::readyRead, this, &WiFlyListener::socket_readyRead);
}


WiFlyListener::~WiFlyListener()
{
}


void WiFlyListener::socket_readyRead()
{
    while (socket.hasPendingDatagrams()) {
        QByteArray      packet;
        QHostAddress    addr;

        packet.resize(socket.pendingDatagramSize());
        socket.readDatagram(packet.data(), packet.size(), &addr);

        // qDebug(
        //     "WiFly message from %s: %s",
        //     qPrintable(addr.toString()),
        //     qPrintable(packet.toHex())
        // );

        WiFlyClientInfo ci;

        if (ci.fromPacket(packet, addr))
            clients[addr] = ci;
    }
}
