thomask77/drquad32/Attic/attitude.c

#include "attitude.h"
#include "util.h"
#include <stdio.h>

struct dcm dcm = {
    .matrix    = MAT3_IDENTITY,
    .down_ref  = { 0,  0, -1 },
    .north_ref = { 1,  0,  0 },
/*
    .acc_kp = 1, .acc_ki = 0.001,
    .mag_kp = 0, .mag_ki = 0
*/
};


/**
 * Apply an infinitesimal rotation w*dt to a direction cosine matrix A.
 * An orthonormalization step is added to prevent rounding errors.
 *
 * Without the normalization, this would be a simple matrix multiplication:
 *
 * return mat3_matmul( A, (mat3f) {
 *        1,   -w.z,  w.y,
 *      w.z,    1, -w.x,
 *     -w.y,  w.x,    1
 * };
 */
static mat3f dcm_integrate(mat3f A, vec3f w, float dt)
{
    w = vec3f_scale(w, dt);

    // Calculate the new x and y axes. z is calculated later.
    //
    vec3f x = vec3f_matmul(A, (vec3f){    1, w.z, -w.y } );
    vec3f y = vec3f_matmul(A, (vec3f){ -w.z,   1,  w.x } );

    // Orthonormalization
    //
    // First we compute the dot product of the x and y rows of the matrix, which
    // is supposed to be zero, so the result is a measure of how much the X and Y
    // rows are rotating toward each other
    //
    float error = vec3f_dot(x, y);

    // We apportion half of the error each to the x and y rows, and approximately
    // rotate the X and Y rows in the opposite direction by cross coupling:
    //
    vec3f xo, yo, zo;
    xo = vec3f_sub(x, vec3f_scale(y, 0.5 * error));
    yo = vec3f_sub(y, vec3f_scale(x, 0.5 * error));

    // Scale them to unit length and take a cross product for the Z axis
    //
    xo = vec3f_norm_fast(xo);
    yo = vec3f_norm_fast(yo);
    zo = vec3f_cross(xo, yo);

    return (mat3f) {
        xo.x, yo.x, zo.x,
        xo.y, yo.y, zo.y,
        xo.z, yo.z, zo.z
    };
}


extern void dcm_update(vec3f gyro, vec3f acc, float dt)
{
    dcm.offset_p = vec3f_zero;

    // Apply accelerometer correction
    //
    vec3f down  = vec3f_matmul(dcm.matrix, vec3f_norm_fast(acc));
    vec3f error = vec3f_cross(down, dcm.down_ref);

    dcm.debug = error;

    dcm.offset_p = vec3f_add(dcm.offset_p, vec3f_scale(error, dcm.acc_kp));
    dcm.offset_i = vec3f_add(dcm.offset_i, vec3f_scale(error, dcm.acc_ki));

    // todo: magnetometer correction, once we have one

    // Calculate drift-corrected roll, pitch and yaw angles
    //
    dcm.omega = gyro;
    dcm.omega = vec3f_add(dcm.omega, dcm.offset_p);
    dcm.omega = vec3f_add(dcm.omega, dcm.offset_i);

    // Apply rotation to the direction cosine matrix
    //
    dcm.matrix = dcm_integrate(dcm.matrix, dcm.omega, dt);
    dcm.euler = mat3f_to_euler(dcm.matrix);
}


void  dcm_reset(void)
{
    dcm.matrix   = mat3f_identity;
    dcm.euler    = vec3f_zero;
    dcm.omega    = vec3f_zero;
    dcm.offset_p = vec3f_zero;
    dcm.offset_i = vec3f_zero;
}

// -----
#include <string.h>


void cmd_dcm_show(void)
{
    struct dcm d;
    ATOMIC_COPY(&d, &dcm, sizeof(d));

    printf("                x/roll    y/pitch      z/yaw\n");
    printf("down_ref  : %10.4f %10.4f %10.4f\n", d.down_ref.x, d.down_ref.y, d.down_ref.z);
    printf("north_ref : %10.4f %10.4f %10.4f\n", d.north_ref.x, d.north_ref.y, d.north_ref.z);
    printf("\n");
    printf("offset_p  : %10.4f %10.4f %10.4f\n", d.offset_p.x, d.offset_p.y, d.offset_p.z);
    printf("offset_i  : %10.4f %10.4f %10.4f\n", d.offset_i.x, d.offset_i.y, d.offset_i.z);
    printf("\n");
    printf("dcm_omega : %10.4f %10.4f %10.4f\n", d.omega.x, d.omega.y, d.omega.z);
    printf("dcm_euler : %10.4f %10.4f %10.4f\n", d.euler.x, d.euler.y, d.euler.z);
    printf("\n");
    printf("dcm_matrix: %10.4f %10.4f %10.4f\n", d.matrix.m00, d.matrix.m01, d.matrix.m02);
    printf("            %10.4f %10.4f %10.4f\n", d.matrix.m10, d.matrix.m11, d.matrix.m12);
    printf("            %10.4f %10.4f %10.4f\n", d.matrix.m20, d.matrix.m21, d.matrix.m22);
    printf("\n");
    printf("debug     : %10.4f %10.4f %10.4f\n", d.debug.x, d.debug.y, d.debug.z);
}
