thomask77/drquad32/QuadControl/TangoColors.h

#ifndef TANGOCOLORS_H
#define TANGOCOLORS_H

#include <QColor>

// http://tango.freedesktop.org/Tango_Icon_Theme_Guidelines
//
class TangoColors {
public:
    static const QColor Butter1;
    static const QColor Butter2;
    static const QColor Butter3;
    static const QColor Chameleon1;
    static const QColor Chameleon2;
    static const QColor Chameleon3;
    static const QColor Orange1;
    static const QColor Orange2;
    static const QColor Orange3;
    static const QColor SkyBlue1;
    static const QColor SkyBlue2;
    static const QColor SkyBlue3;
    static const QColor Plum1;
    static const QColor Plum2;
    static const QColor Plum3;
    static const QColor Chocolate1;
    static const QColor Chocolate2;
    static const QColor Chocolate3;
    static const QColor ScarletRed1;
    static const QColor ScarletRed2;
    static const QColor ScarletRed3;
    static const QColor Aluminium1;
    static const QColor Aluminium2;
    static const QColor Aluminium3;
    static const QColor Aluminium4;
    static const QColor Aluminium5;
    static const QColor Aluminium6;
};

// Colors from the GNOME Human Interface Guidelines 2.2.1
// http://developer.gnome.org/hig-book/2.91/design-color.html.en
//
class GnomeColors {
public:
    static const QColor Basic3DHilight;
    static const QColor Basic3DMedium;
    static const QColor Basic3DDark;
    static const QColor _3DShadow;
    static const QColor GreenHilight;
    static const QColor GreenMedium;
    static const QColor GreenDark;
    static const QColor GreenShadow;
    static const QColor RedHilight;
    static const QColor RedMedium;
    static const QColor RedDark;
    static const QColor RedShadow;
    static const QColor PurpleHilight;
    static const QColor PuprpleMedium;
    static const QColor PurpleDark;
    static const QColor PurpleShadow;
    static const QColor BlueHilight;
    static const QColor BlueMedium;
    static const QColor BlueDark;
    static const QColor BlueShadow;
    static const QColor FaceSkinHilight;
    static const QColor FaceSkinMedium;
    static const QColor FaceSkinDark;
    static const QColor FaceSkinShadow;
    static const QColor AccentRed;
    static const QColor AccentRedDark;
    static const QColor AccentYellow;
    static const QColor AccentYellowDark;
    static const QColor AccentGreen;
    static const QColor AccentGreenDark;
    static const QColor White;
    static const QColor Black;
};

#endif
