thomask77/drquad32/QuadControl/Connection.h

#ifndef CONNECTION_H
#define CONNECTION_H

#include <QObject>
#include <QSerialPort>
#include <QTimer>
#include <QUrl>

#include "Shared/msg_structs.h"


class Connection : public QObject
{
    Q_OBJECT

public:
    explicit Connection(QObject *parent = 0);
    ~Connection();

    struct Statistics {
        uint    rx_bytes;
        uint    rx_packets;
        uint    rx_errors;
        uint    tx_bytes;
        uint    tx_packets;
        uint    tx_errors;
    };

    Statistics stats = Statistics();

    bool openUrl(const QUrl &url);
    QUrl getUrl();

    QString errorString();

    void close();
    bool isOpen();

    bool sendMessage(msg_header *msg);

signals:
    void messageReceived(const msg_generic &msg);
    void connectionChanged();

private:
    QIODevice   *ioDevice = NULL;
    QUrl        m_url;
    QString     m_errorString;
    QByteArray  rx_buf;

    bool openIoDevice(QIODevice *ioDevice);
    bool openSerial(const QString &getUrl, int baudRate);
    bool openSocket(const QString &address, quint16 port);
    bool openFile(const QString &fileName);

    void ioDevice_readyRead();
    void parseMessages();

    bool encodeMessage(msg_header *msg, QByteArray *packet);
    bool decodeMessage(const QByteArray &packet, msg_generic *msg);
};


#endif // CONNECTION_H
