thomask77/drquad32/QuadControl/BootProtocol.cpp

/**
 * Copyright (C)2015 Thomas Kindler <mail_drquad@t-kindler.de>
 *
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
 * You should have received a copy of the GNU General Public License
 * along with this program.  If not, see <http://www.gnu.org/licenses/>.
 */

#include "BootProtocol.h"
#include "Shared/msg_structs.h"
#include "Shared/errors.h"
#include "Shared/crc32.h"

#include <QDebug>
#include <QApplication>
#include <QThread>
#include <QTime>
#include "IntelHexFile.h"
#include "MainWindow.h"


BootProtocol::BootProtocol(Connection &connection, QObject *parent)
    : QObject(parent)
    , progressDialog(mainWindow)
    , connection(connection)
{
    progressDialog.setWindowModality(Qt::WindowModal);
    progressDialog.setWindowTitle("Updating...");

    connect(&connection, &Connection::messageReceived, this, &BootProtocol::connection_messageReceived);
}


BootProtocol::~BootProtocol()
{
}


void BootProtocol::connection_messageReceived(const msg_generic &msg)
{
    messageQueue.enqueue(msg);
}


void BootProtocol::showProgress(int value, const QString &text)
{
    progressDialog.setValue(value);
    progressDialog.setLabelText(text);
}


/********** Low level functions **********/

bool BootProtocol::bootGetResponse(msg_boot_response *response, int timeout)
{
    while (timeout > 0) {
        while (!messageQueue.isEmpty()) {
            const auto msg = messageQueue.dequeue();

            if (msg.h.id == MSG_ID_BOOT_RESPONSE) {
                const auto res = (const msg_boot_response&)msg;
                if (res.error != 0) {
                    m_errorString = _user_strerror(res.error);
                    return false;
                }

                if (response != NULL)
                    *response = res;
                return true;
            }
        }

        QApplication::processEvents();
        QThread::msleep(10);    // don't hog the cpu..
        timeout -= 10;
    }

    m_errorString = _user_strerror(EMSG_TIMEOUT);
    return false;
}


bool BootProtocol::bootReboot()
{
    // TODO: implement reboot command in firmware
    // HACK: send ctrl-c + reset
    //
    const char *s = "\03\nreset\n";

    msg_shell_from_pc msg;
    msg.h.id = MSG_ID_SHELL_FROM_PC;
    msg.h.data_len = strlen(s);
    strcpy((char*)msg.data, s);

    connection.sendMessage(&msg.h);

    bootGetResponse(NULL, 500);
    return true;    // ignore errors
}


bool BootProtocol::bootEnter()
{
    bootReboot();

    msg_boot_enter msg;
    msg.h.id = MSG_ID_BOOT_ENTER;
    msg.h.data_len = 4;
    msg.magic = BOOT_ENTER_MAGIC;

    connection.sendMessage(&msg.h);

    return bootGetResponse(NULL, 500);
}


bool BootProtocol::bootExit()
{
    msg_boot_exit msg;
    msg.h.id = MSG_IG_BOOT_EXIT;
    msg.h.data_len = 0;

    connection.sendMessage(&msg.h);

    return bootGetResponse(NULL);
}


bool BootProtocol::bootEraseSector(uint sector)
{
    msg_boot_erase_sector msg;
    msg.h.id = MSG_ID_BOOT_ERASE_SECTOR;
    msg.h.data_len = 4;
    msg.sector = sector;

    connection.sendMessage(&msg.h);

    return bootGetResponse(NULL);
}


bool BootProtocol::bootWriteDataAsync(uint addr, const QByteArray &data)
{
    assert((uint)data.length() <= sizeof(msg_boot_write_data::data));

    msg_boot_write_data msg;
    msg.h.id = MSG_ID_BOOT_WRITE_DATA;
    msg.h.data_len = 4 + data.length();
    msg.address = addr;

    memcpy(msg.data, data.constData(), data.length());

    connection.sendMessage(&msg.h);

    return true;
}


bool BootProtocol::bootWriteData(uint addr, const QByteArray &data)
{
    static const int chunk_size = sizeof(msg_boot_write_data::data);

    int chunks = (data.length() + chunk_size - 1) / chunk_size;
    int offset = 0;

    int window = std::min(ack_window, chunks);

    for (int i=0; i < chunks + window; i++) {
        // send data
        //
        if (i < chunks) {
            showProgress(
                offset * 100 / data.length(),
                QString().sprintf("Writing 0x%08x", addr + offset)
            );

            bootWriteDataAsync(addr + offset, data.mid(offset, chunk_size) );
            offset += chunk_size;

            if (progressDialog.wasCanceled())
                return true;
        }

        // check responses later to mask the connection latency
        //
        if (i >= window && !bootGetResponse(NULL))
            return false;
    }

    return true;
}


bool BootProtocol::bootVerifyData(uint addr, const QByteArray &data)
{
    msg_boot_verify msg;
    msg.h.id = MSG_ID_BOOT_VERIFY;
    msg.h.data_len = 4 + 4;
    msg.address = addr;
    msg.length  = data.length();

    connection.sendMessage(&msg.h);

    msg_boot_response res;
    if (!bootGetResponse(&res))
        return false;

    uint32_t remote_crc;
    memcpy(&remote_crc, res.data, 4);

    uint32_t local_crc = crc32_init();
    local_crc = crc32_update(local_crc, (const uchar*)data.constData(), data.length());
    local_crc = crc32_finalize(local_crc);

    if  (remote_crc != local_crc) {
        m_errorString = QString("CRC failure. Expected %1, got %2")
                .arg(local_crc, 2, 16) .arg(remote_crc, 2, 16);
        return false;
    }

    return true;

}


/********** Firmware update functions **********/

#define STEP(function)  do {            \
    if (!(function))                    \
        return false;                   \
    if (progressDialog.wasCanceled())   \
        return true;                    \
} while(0);


bool BootProtocol::sendHexFile(const QString &fileName)
{
    progressDialog.reset();
    progressDialog.show();

    showProgress(0, "Loading " + fileName);

    IntelHexFile ih;
    if (!ih.loadHex(fileName)) {
        m_errorString = ih.errorString();
        return false;
    }

    auto t0 = QTime::currentTime();

    int tries=0, ok=0;
    while (!ok) {
        showProgress(tries++ * 10 % 100, "Entering bootloader");
        STEP( (ok=bootEnter(), true) );
    }

    auto t_enter = QTime::currentTime();

    for (int i=4; i<12; i++) {
        showProgress(
            100 * (i-4) / (12-4),
            QString().sprintf("Erasing sector %d...", i)
        );
        STEP( bootEraseSector(i) );
    }

    auto t_erase = QTime::currentTime();

    for (auto s: ih.sections) {
        STEP( bootWriteData(s.offset, s.data) );

        showProgress(80, "Verifying");
        STEP( bootVerifyData(s.offset, s.data) );
    }

    auto t_write = QTime::currentTime();

    showProgress(90, "Starting application");
    STEP( bootExit() );

    showProgress(100, "Done.");

    auto t_total =  QTime::currentTime();

    qDebug("  Enter:  %d ms", t0.msecsTo(t_enter));
    qDebug("  Erase:  %d ms", t_enter.msecsTo(t_erase));
    qDebug("  Write:  %d ms", t_erase.msecsTo(t_write));
    qDebug("  Total:  %d ms", t0.msecsTo(t_total));

    return true;
}


QString BootProtocol::errorString()
{
    return m_errorString;
}
