thomask77/drquad32/(commit log)

2014-12-17 Updated schematics and BOM
    [DrQuad32 Mainboard (Rev B draft) BOM.ods]
2014-12-21 Bootloader: fixed hang in uart_flush
2014-12-21 Early initialization for the xbee uart. We can now see assertions during FreeRTOS startup.
2014-12-21 Fixed assertion in get_us_time64
    [ustime.c]
2014-12-21 Fixed assertion in VCP_DataTx
    [term_usb.c]
2014-12-21 Fixed command table when using -flto
    [command.h]
2014-12-21 malloc_lock without disabling interrupts
2014-12-22 FlashTool: Fixed images on buttons
2014-12-27 FlashTool: Filter out "by: ..:" comments from _ui.py files
2015-02-16 Started a rewrite of QuadControl in C++ / Qt
    PyQt proved to be problematic for various reasons. Python2+PyQt4 has been
    discontinued in recent Ubuntu releases, and the newer Python3+Qt5 had some
    problems under windows.
    This port will run with Qt >= 5.3 on Win32/mingw, Linux and MacOS.
    Compile using QtCreator.
    [DrQuad32 Mainboard (Rev B draft) BOM.ods]
2015-02-16 Added copyright headers. Fixed compilation bugs under Linux.
    [AnsiParser.cpp, AnsiParser.h, BootProtocol.cpp, BootProtocol.h, Connection.cpp, Connection.h]
2015-02-16 Error table with double-include
    [BootProtocol.cpp, BootProtocol.h, IntelHexFile.cpp, IntelHexFile.h, errors.c, errors.h, main.c]
2015-02-16 Tool for inserting a CRC checksum into the ELF file.
    The add_version_info.py script inserts a checksum and version information
    after linking the ELF file. The checksum is forged, so that the bootloader
    can run a simple check over the complete binary.
    See
    http://blog.stalkr.net/2011/03/crc-32-forging.html
    http://www.woodmann.com/fravia/crctut1.htm
    for details.
2015-02-18 Simplified bootloader responses, better error handling
    Moved errors.c/.h from Bootloader to Source
    Moved msg_struct.h from Bootloader to Source
    Fixed file permissions :/ (have to find out a better way on cygwin)
    [BootProtocol.cpp, BootProtocol.h, Connection.h, IntelHexFile.cpp, IntelHexFile.h]
2015-02-18 Moved CRC, COBS and errors.h to a new "Shared" directory. COBS now uses void* for source and destination and reports errors through errno. Integrated COBS LICENSE.TXT into the source code.
    [BootProtocol.cpp, Connection.cpp, Connection.h]
2015-02-19 Added a known bugs section Some clean-up
    [msg_structs.h]
2015-03-03 software flow control
2015-07-04 windows task bar progress works again, fixed auto firmware update when not connected
    [BootProtocol.cpp, BootProtocol.h, QProgressDialogEx.h]
2015-07-04 Bootloader: Use normal CRC16/32 and newlib printf. Size doesn't matter that much.
    [main.c, msg_packet.c, small_printf.c, small_printf.h, uart.c, uart.h]
2015-07-06 QuadControl: GLWindow ported to QOpenGLWidget. GLU functions still missing.
    [GLTools.cpp, GLTools.h, MainWindow.cpp]
